tcellerier/HeaterActuatorNetatmo/photos/1. Vanne motorisée.jpg

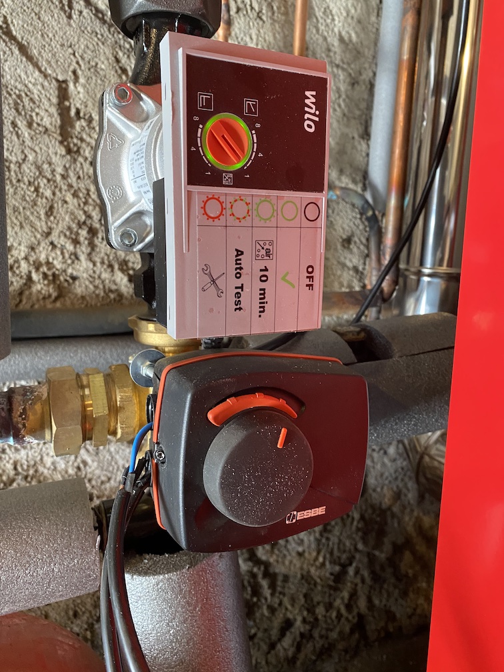
photos/1. Vanne motorisée.jpg
