tcellerier/HeaterActuatorNetatmo/photos/3. Arduino.jpg

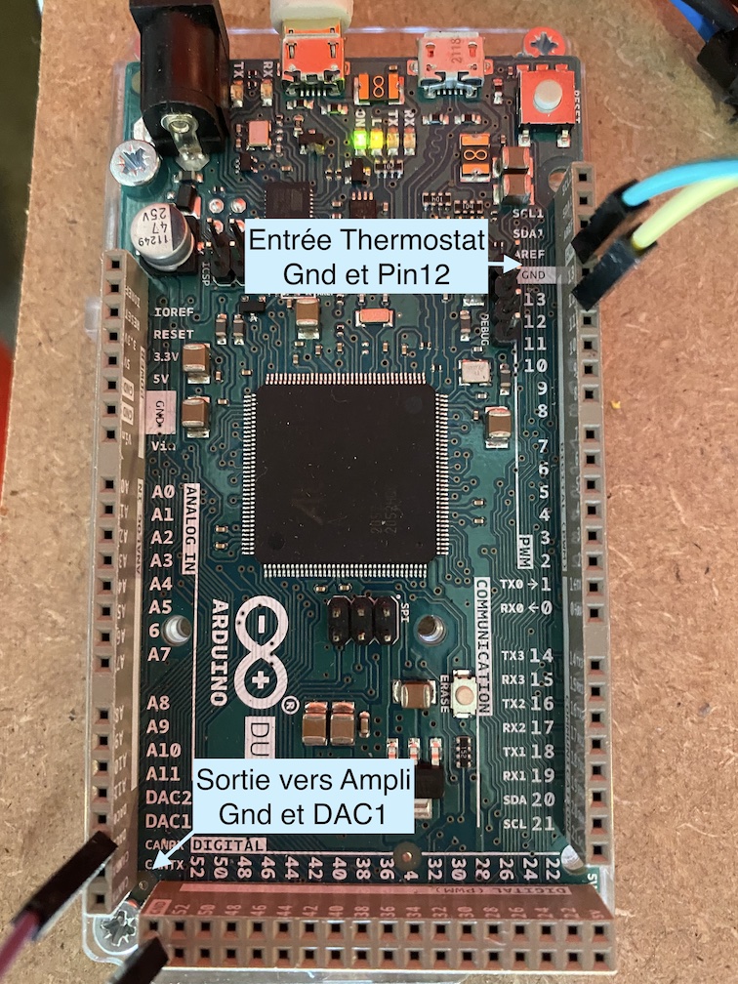
photos/3. Arduino.jpg
