tcellerier/HeaterActuatorNetatmo/photos/4. Ampli tension pins.png

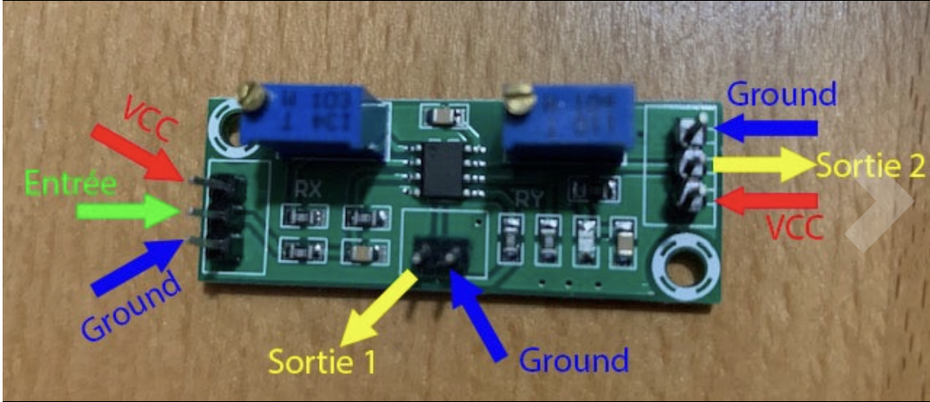
photos/4. Ampli tension pins.png
