tcellerier/HeaterActuatorNetatmo/photos/4. Ampli tension.jpg

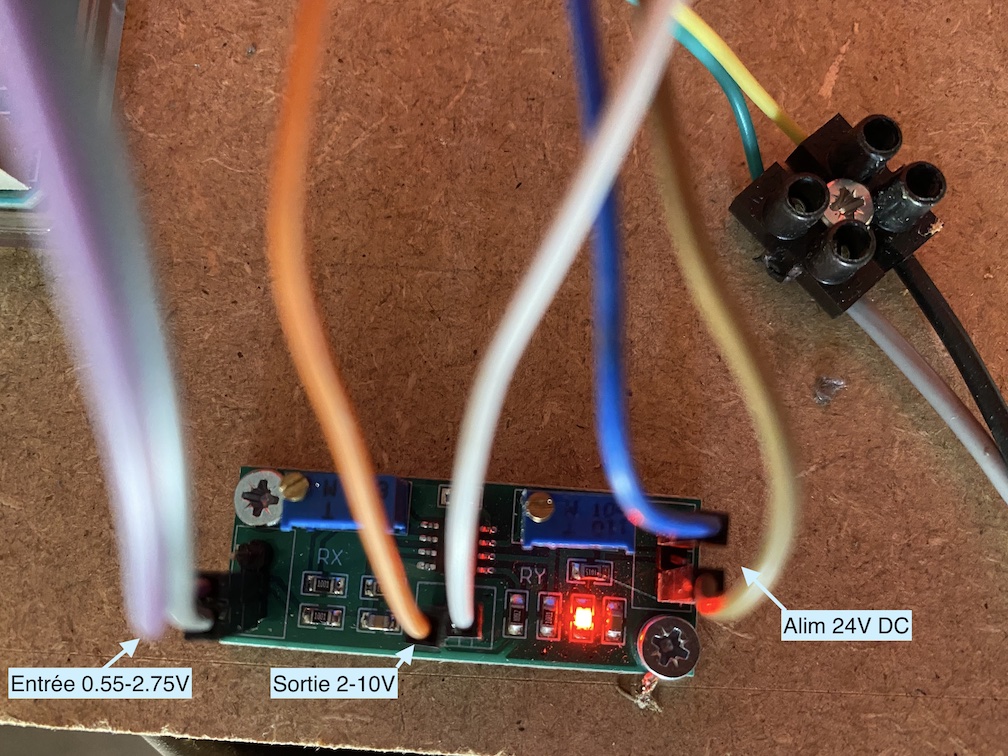
photos/4. Ampli tension.jpg
